asid61/MCL/MCL-102-2 IQ100 brushless/Sim/Draft1.asc

D1: schottky; 1N5818
M1: nmos; BSP89
R1: res; 330
R2: res; 2.2k
R3: res; 22k
R4: res; {X}
V1: voltage; PULSE(0 3.3 1m 10n 10n 1m 2m)
V2: voltage; 3.3
Named nets: 0, cs, brksw
.step param X list 1G 1
.tran 2m
