asid61/MCL/MCL-102-2 IQ100 brushless/Sim/Supplyvoltage.asc

C1: cap; 1360µ; V=25 Irms=4 Rser=20m
C2: cap; 12µ; x2
C3: cap; 10µ; Rser=1
C4: cap; 15µ; Rser=3m
D1: schottky; 1N5817
L1: ind; 3µ
L2: ind; 3µ
M1: nmos; Si7336ADP
R1: res; 40m
R2: res; 0.05
R3: res; 10
R4: res; 80
U1: ADP7118-3.3
V1: voltage; 12
V2: voltage; PULSE(0 12 0 10n 10n 25u 50u)
Named nets: 0
.tran 5m
