asid61/MCL/MCL-102-2 IQ100 brushless/MCL-102-2.kicad_pcb

## KiCad design MCL-102-2 IQ100 brushless/MCL-102-2.kicad_pcb (2025-07-22)

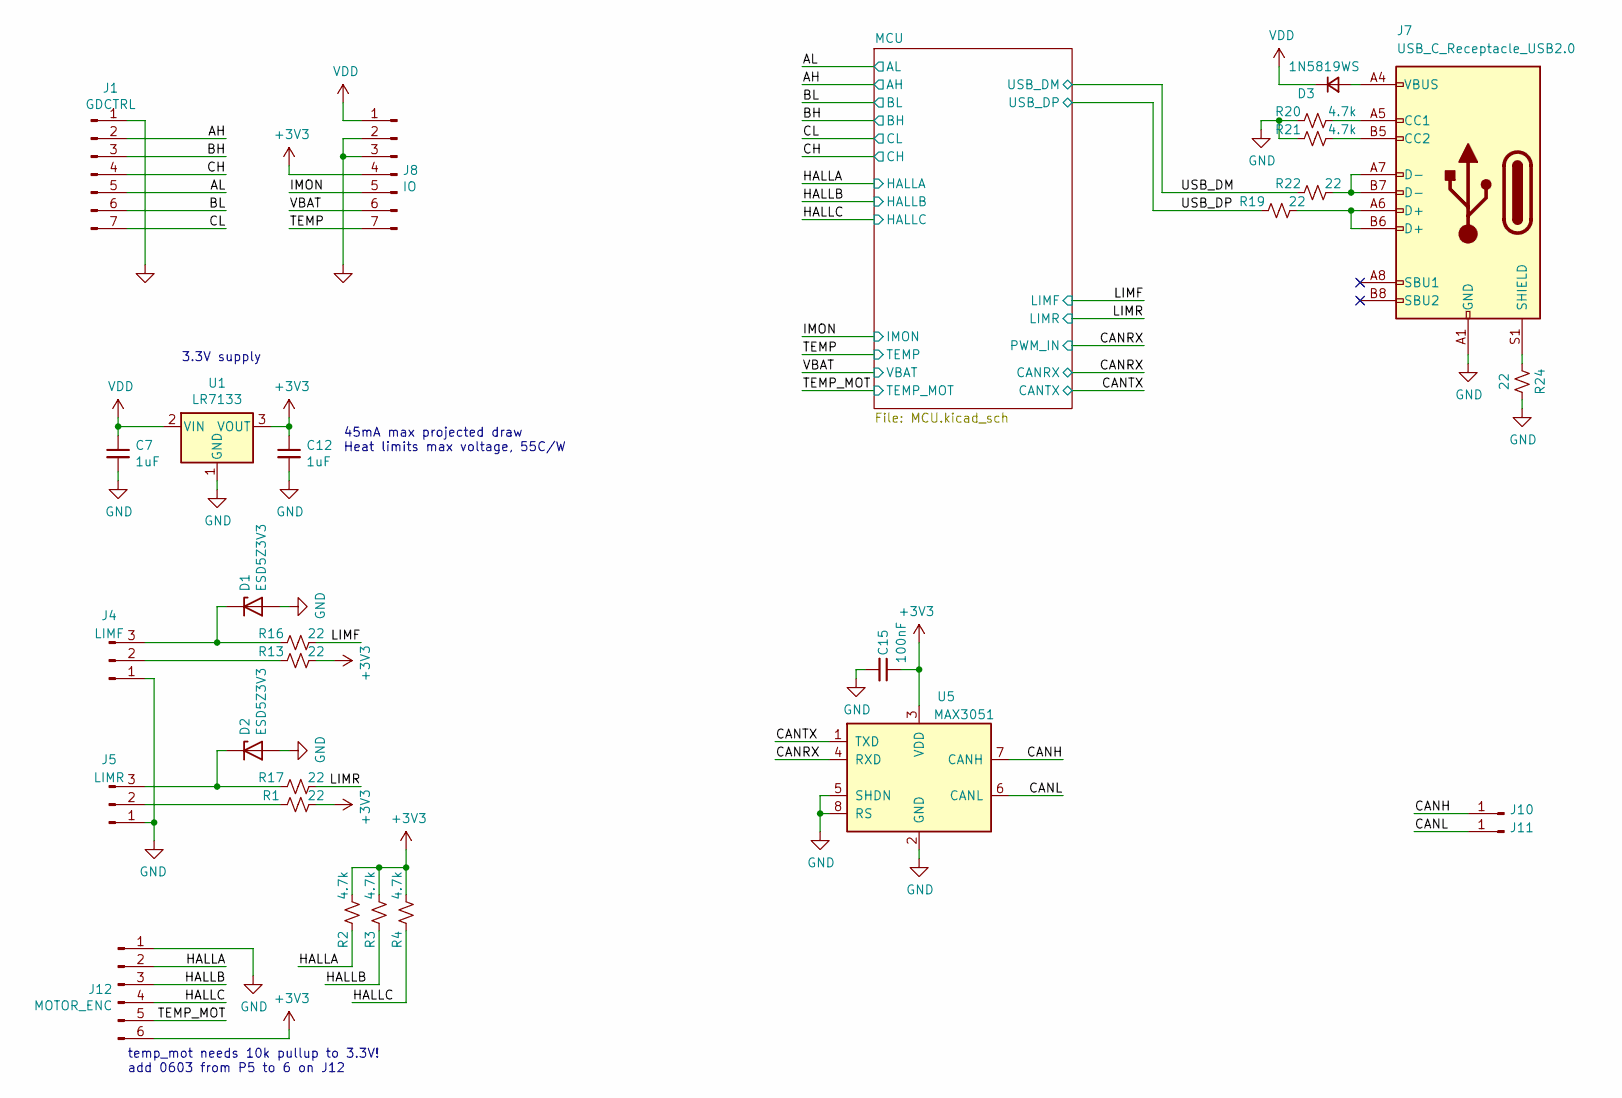
[picture p1: schematic MCL-102-2.kicad_sch]

Parts:
C7, C12: 1uF; C_0603_1608Metric; LCSC C15849
C15: 100nF; C_0402_1005Metric
D1, D2: ESD5Z3V3; D_SOD-523; LCSC C502545
D3: 1N5819WS; D_SOD-323; LCSC C191023
J1: GDCTRL; PinSocket_1x07_P2.54mm_Vertical; LCSC C492406
J4: LIMF; PinHeader_1x03_P2.54mm_Horizontal
J5: LIMR; PinHeader_1x03_P2.54mm_Horizontal
J7: USB_C_Receptacle_USB2.0; USB_C_Receptacle_HRO_TYPE-C-31-M-12; LCSC C165948
J8: IO; PinSocket_1x07_P2.54mm_Vertical; LCSC C492406
J10, J11: Conn_01x01_Male; SOLDERPAD_100x200
J12: MOTOR_ENC; JST_PH_S6B-PH-SM4-TB_1x06-1MP_P2.00mm_Horizontal; LCSC C146050
R1, R13, R16, R17, R19, R22, R24: 22; R_0402_1005Metric
R2, R3, R4, R20, R21: 4.7k; R_0402_1005Metric
U1: LR7133; SOT-89-3; LCSC C914127
U5: MAX3051; SOT-23-8; LCSC C112005

Connections:
+3V3: C12.1, C15.1, J8.4, J12.6, R1.2, R2.1, R3.1, R4.1, R13.2, U1.3 (VOUT), U5.3 (VDD); also elsewhere on the board
/AH: J1.2; also elsewhere on the board
/AL: J1.5; also elsewhere on the board
/BH: J1.3; also elsewhere on the board
/BL: J1.6; also elsewhere on the board
/CANH: J10.1, U5.7 (CANH)
/CANL: J11.1, U5.6 (CANL)
/CANRX: U5.4 (RXD); also elsewhere on the board
/CANTX: U5.1 (TXD); also elsewhere on the board
/CH: J1.4; also elsewhere on the board
/CL: J1.7; also elsewhere on the board
/HALLA: J12.2, R2.2; also elsewhere on the board
/HALLB: J12.3, R3.2; also elsewhere on the board
/HALLC: J12.4, R4.2; also elsewhere on the board
/IMON: J8.5; also elsewhere on the board
/LIMF: R16.2; also elsewhere on the board
/LIMR: R17.2; also elsewhere on the board
/TEMP: J8.7; also elsewhere on the board
/TEMP_MOT: J12.5; also elsewhere on the board
/USB_DM: R22.1; also elsewhere on the board
/USB_DP: R19.1; also elsewhere on the board
/VBAT: J8.6; also elsewhere on the board
GND: C7.2, C12.2, C15.2, D1.2 (A), D2.2 (A), J1.1, J4.1, J5.1, J7.A1 (GND), J7.A12 (GND), J7.B1 (GND), J7.B12 (GND), J8.2, J8.3, J12.1, R20.2, R21.2, R24.1, U1.1 (GND), U5.2 (GND), U5.5 (SHDN), U5.8 (RS); also elsewhere on the board
unnamed: D1.1 (K), J4.3, R16.1
unnamed: D2.1 (K), J5.3, R17.1
unnamed: D3.2 (A), J7.A4 (VBUS), J7.A9 (VBUS), J7.B4 (VBUS), J7.B9 (VBUS)
unnamed: J4.2, R13.1
unnamed: J5.2, R1.1
unnamed: J7.A5 (CC1), R20.1
unnamed: J7.A6 (D+), J7.B6 (D+), R19.2
unnamed: J7.A7 (D-), J7.B7 (D-), R22.2
unnamed: J7.B5 (CC2), R21.1
unnamed: J7.S1 (SHIELD), R24.2
VDD: C7.1, D3.1 (K), J8.1, U1.2 (VIN)

Notes on the sheet:
temp_mot needs 10k pullup to 3.3V! add 0603 from P5 to 6 on J12
3.3V supply
45mA max projected draw Heat limits max voltage, 55C/W

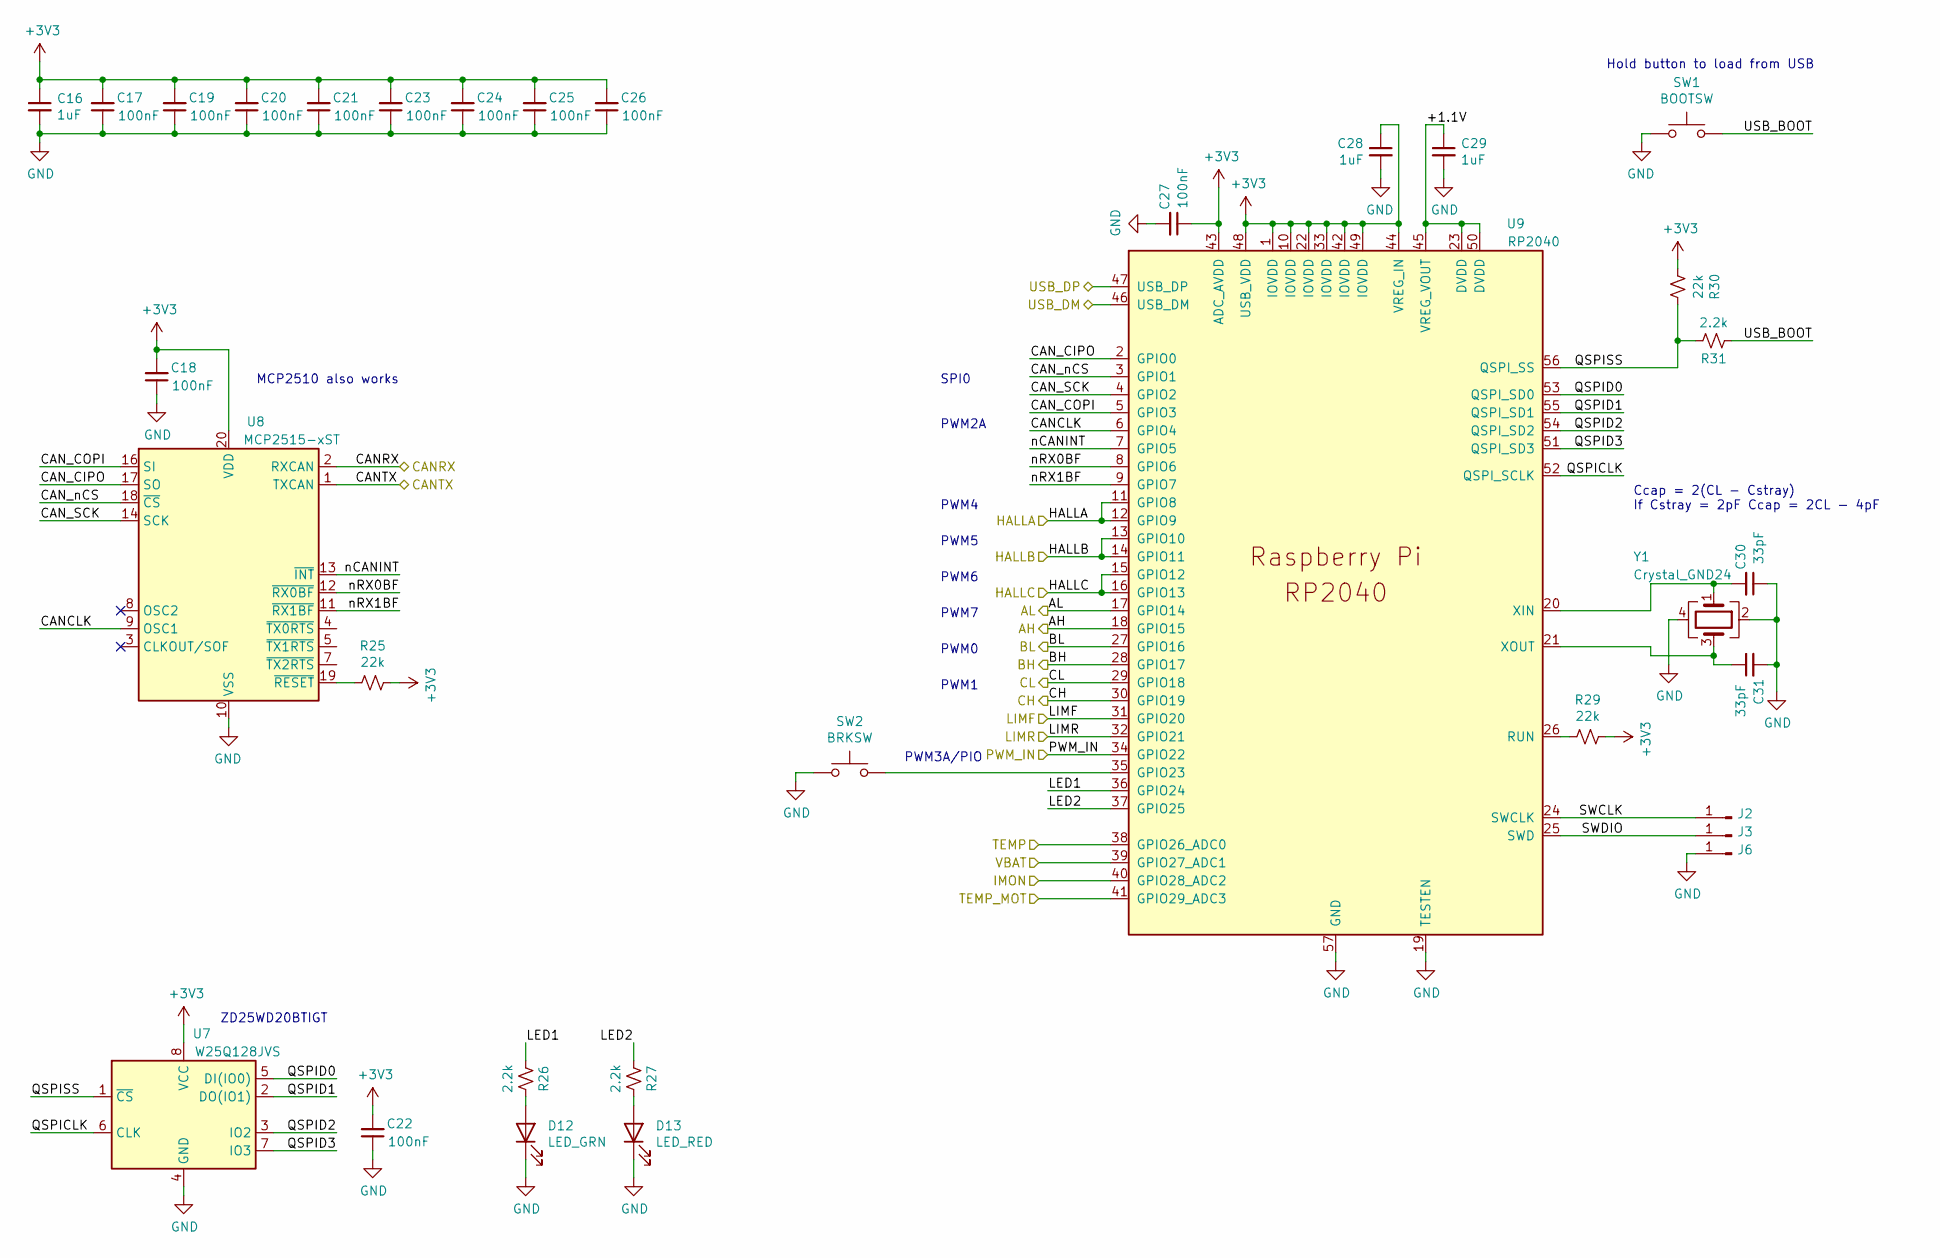
[picture p2: schematic MCU.kicad_sch]

Parts:
C16, C28, C29: 1uF; C_0603_1608Metric; LCSC C15849
C17, C18, C19, C20, C21, C22, C23, C24, C25, C26, C27: 100nF; C_0402_1005Metric
C30, C31: 33pF; C_0402_1005Metric
D12: LED_GRN; D_0603_1608Metric
D13: LED_RED; D_0603_1608Metric
J2, J3, J6: Conn_01x01_Male; SOLDERPAD_100x200
R25, R29, R30: 22k; R_0402_1005Metric
R26, R27, R31: 2.2k; R_0402_1005Metric
SW1: BOOTSW; SW_PUSH_6mm_H4.3mm; LCSC C2837531
SW2: BRKSW; SW_PUSH_6mm_H4.3mm; LCSC C2837531
U7: W25Q128JVS; SOIC-8_5.23x5.23mm_P1.27mm; LCSC C97521
U8: MCP2515-xST; TSSOP-20_4.4x6.5mm_P0.65mm; LCSC C185941
U9: RP2040; RP2040-QFN-56; LCSC C2040
Y1: Crystal_GND24; Crystal_SMD_3225-4Pin_3.2x2.5mm; LCSC C9002

Connections:
+3V3: C16.1, C17.2, C18.2, C19.2, C20.2, C21.2, C22.2, C23.2, C24.2, C25.2, C26.2, C27.1, C28.1, R25.2, R29.2, R30.1, U7.8 (VCC), U8.20 (VDD), U9.1 (IOVDD), U9.10 (IOVDD), U9.22 (IOVDD), U9.33 (IOVDD), U9.42 (IOVDD), U9.43 (ADC_AVDD), U9.44 (VREG_IN), U9.48 (USB_VDD), U9.49 (IOVDD); also elsewhere on the board
/AH: U9.18 (GPIO15); also elsewhere on the board
/AL: U9.17 (GPIO14); also elsewhere on the board
/BH: U9.28 (GPIO17); also elsewhere on the board
/BL: U9.27 (GPIO16); also elsewhere on the board
/CANRX: U8.2 (RXCAN), U9.34 (GPIO22); also elsewhere on the board
/CANTX: U8.1 (TXCAN); also elsewhere on the board
/CH: U9.30 (GPIO19); also elsewhere on the board
/CL: U9.29 (GPIO18); also elsewhere on the board
/HALLA: U9.11 (GPIO8), U9.12 (GPIO9); also elsewhere on the board
/HALLB: U9.13 (GPIO10), U9.14 (GPIO11); also elsewhere on the board
/HALLC: U9.15 (GPIO12), U9.16 (GPIO13); also elsewhere on the board
/IMON: U9.40 (GPIO28_ADC2); also elsewhere on the board
/LIMF: U9.31 (GPIO20); also elsewhere on the board
/LIMR: U9.32 (GPIO21); also elsewhere on the board
/MCU/+1.1V: C29.1, U9.23 (DVDD), U9.45 (VREG_VOUT), U9.50 (DVDD)
/MCU/CANCLK: U8.9 (OSC1), U9.6 (GPIO4)
/MCU/CAN_CIPO: U8.17 (SO), U9.2 (GPIO0)
/MCU/CAN_COPI: U8.16 (SI), U9.5 (GPIO3)
/MCU/CAN_SCK: U8.14 (SCK), U9.4 (GPIO2)
/MCU/CAN_nCS: U8.18 (~CS), U9.3 (GPIO1)
/MCU/LED1: R26.2, U9.36 (GPIO24)
/MCU/LED2: R27.2, U9.37 (GPIO25)
/MCU/QSPICLK: U7.6 (CLK), U9.52 (QSPI_SCLK)
/MCU/QSPID0: U7.5 (DI(IO0)), U9.53 (QSPI_SD0)
/MCU/QSPID1: U7.2 (DO(IO1)), U9.55 (QSPI_SD1)
/MCU/QSPID2: U7.3 (IO2), U9.54 (QSPI_SD2)
/MCU/QSPID3: U7.7 (IO3), U9.51 (QSPI_SD3)
/MCU/QSPISS: R30.2, R31.1, U7.1 (~CS), U9.56 (QSPI_SS)
/MCU/SWCLK: J2.1, U9.24 (SWCLK)
/MCU/SWDIO: J3.1, U9.25 (SWD)
/MCU/USB_BOOT: R31.2, SW1.2
/MCU/nCANINT: U8.13 (~INT), U9.7 (GPIO5)
/MCU/nRX0BF: U8.12 (~RX0BF), U9.8 (GPIO6)
/MCU/nRX1BF: U8.11 (~RX1BF), U9.9 (GPIO7)
/TEMP: U9.38 (GPIO26_ADC0); also elsewhere on the board
/TEMP_MOT: U9.41 (GPIO29_ADC3); also elsewhere on the board
/USB_DM: U9.46 (USB_DM); also elsewhere on the board
/USB_DP: U9.47 (USB_DP); also elsewhere on the board
/VBAT: U9.39 (GPIO27_ADC1); also elsewhere on the board
GND: C16.2, C17.1, C18.1, C19.1, C20.1, C21.1, C22.1, C23.1, C24.1, C25.1, C26.1, C27.2, C28.2, C29.2, C30.1, C31.2, D12.1 (K), D13.1 (K), J6.1, SW1.1, SW2.1, U7.4 (GND), U8.10 (VSS), U9.19 (TESTEN), U9.57 (GND), Y1.2, Y1.4; also elsewhere on the board
unnamed: C30.2, U9.20 (XIN), Y1.1
unnamed: C31.1, U9.21 (XOUT), Y1.3
unnamed: D12.2 (A), R26.1
unnamed: D13.2 (A), R27.1
unnamed: R25.1, U8.19 (~RESET)
unnamed: R29.1, U9.26 (RUN)
unnamed: SW2.2, U9.35 (GPIO23)

Notes on the sheet:
Hold button to load from USB
PWM5
PWM7
PWM1
PWM3A/PIO
MCP2510 also works
PWM2A
Ccap = 2(CL - Cstray) If Cstray = 2pF Ccap = 2CL - 4pF
PWM6
ZD25WD20BTIGT
SPI0
PWM0
PWM4

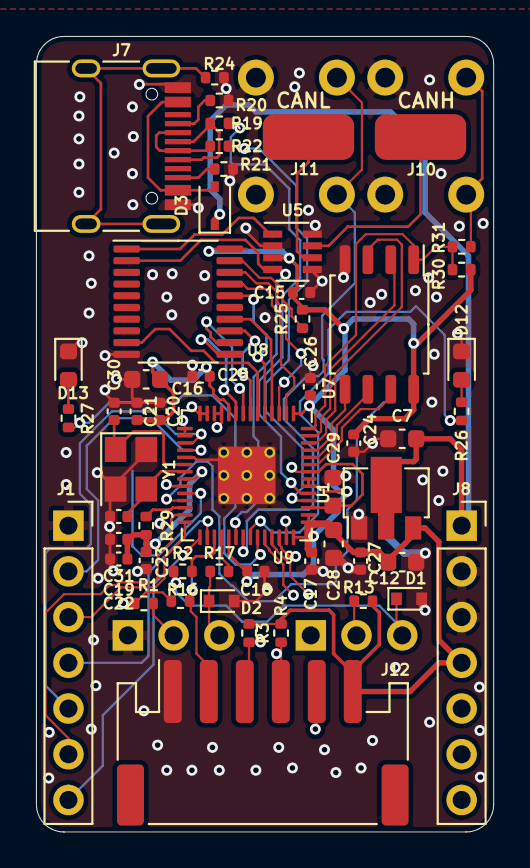
[picture p3: board MCL-102-2.kicad_pcb from above]

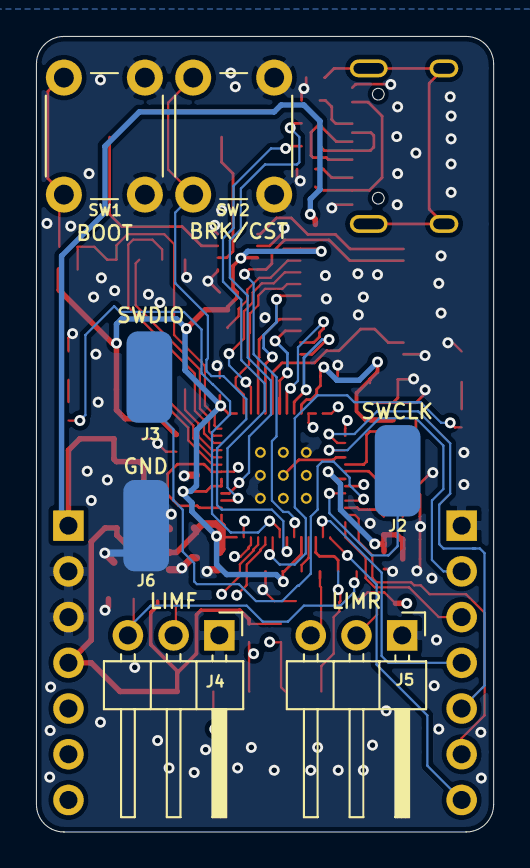
[picture p4: board MCL-102-2.kicad_pcb from below]

Board: 4 copper layers, 25.4 x 44.2 mm, 61 parts (7 on the bottom side), 61 nets.
