asid61/MCL/MCL-102-2 IQ100 brushless/MCL-102 Bridge/MCL-102 Bridge.kicad_pcb

## KiCad design MCL-102-2 IQ100 brushless/MCL-102 Bridge/MCL-102 Bridge.kicad_pcb (2025-07-22)

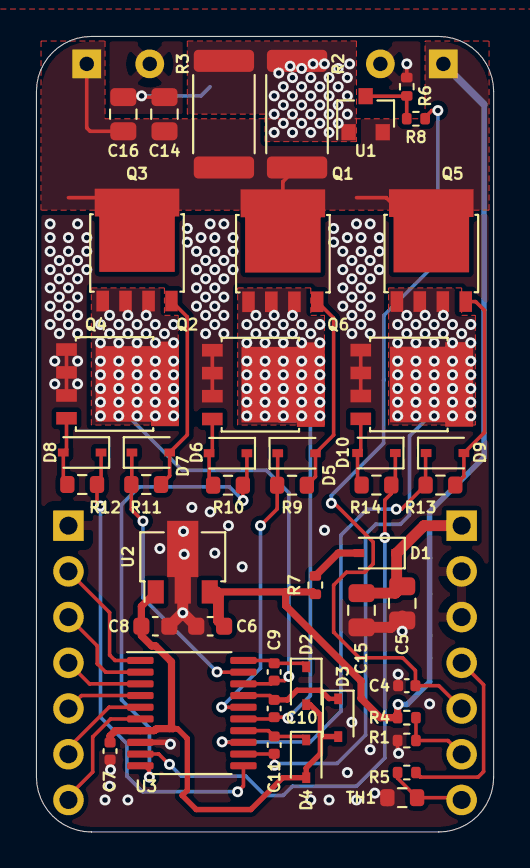
[picture p5: board MCL-102 Bridge.kicad_pcb from above]

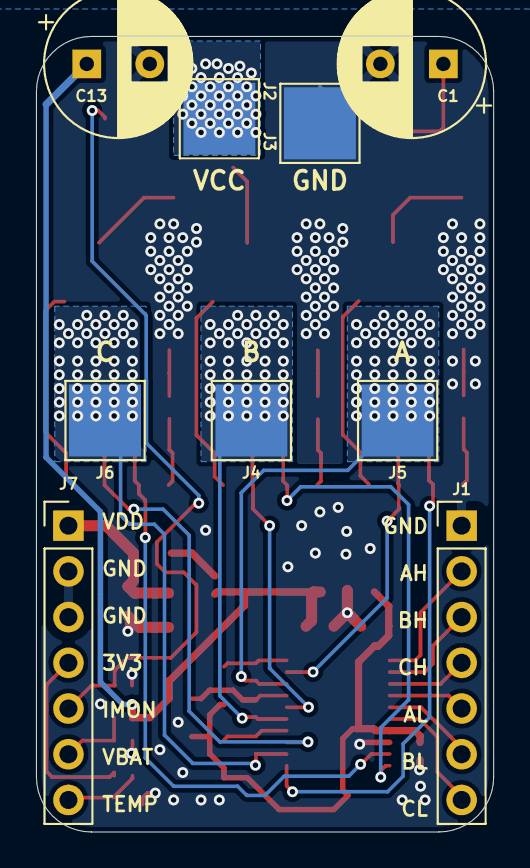
[picture p6: board MCL-102 Bridge.kicad_pcb from below]

Board: 4 copper layers, 25.4 x 44.2 mm, 54 parts (9 on the bottom side), 35 nets.

Parts:
C1, C13: 680uF; CP_Radial_D8.0mm_P3.50mm
C4, C7, C9, C10, C11: 100nF; C_0402_1005Metric
C5, C14, C15, C16: 22uF; C_0805_2012Metric
C6, C8: 1uF; C_0603_1608Metric
D1, D2, D3, D4, D5, D6, D7, D8, D9, D10: 1N4148WS; D_SOD-323
J1: GDCTRL; PinHeader_1x07_P2.54mm_Vertical
J2, J3, J4, J5, J6: Conn_01x01_Male; TestPoint_Pad_4.0x4.0mm
J7: IO; PinHeader_1x07_P2.54mm_Vertical
Q1, Q2, Q3, Q4, Q5, Q6: HYG013N03LS1C2; LFPAK56
R1: 4.7k; R_0402_1005Metric
R2, R3: 0.001; R_2512_6332Metric
R4: 22k; R_0402_1005Metric
R5, R6, R8: 2.2k; R_0402_1005Metric
R7: 22; R_0402_1005Metric
R9, R10, R11, R12, R13, R14: 1; R_0603_1608Metric
TH1: 10k; R_0603_1608Metric
U1: ZXCT1009F; SOT-23
U2: L78L12_SOT89; SOT-89-3
U3: EG2133; TSSOP-20_4.4x6.5mm_P0.65mm

Connections:
+3V3: J7.4, R1.2
+12V: C7.2, C8.1, D2.2 (A), D3.2 (A), D4.2 (A), U2.1 (OUT), U3.7 (VCC)
/AH: J1.2, U3.1 (HIN1)
/AHO: D7.1 (K), R11.1, U3.19 (HO1)
/AL: J1.5, U3.4 (~LIN1)
/ALO: D8.1 (K), R12.1, U3.11 (LO1)
/BH: J1.3, U3.2 (HIN2)
/BHO: D5.1 (K), R9.1, U3.16 (HO2)
/BL: J1.6, U3.5 (~LIN2)
/BLO: D6.1 (K), R10.1, U3.10 (LO2)
/CH: J1.4, U3.3 (HIN3)
/CHO: D9.1 (K), R13.1, U3.13 (HO3)
/CL: J1.7, U3.6 (~LIN3)
/CLO: D10.1 (K), R14.1, U3.9 (LO3)
/IMON: C4.2, J7.5, R8.2
/MA: C9.1, J5.1, Q3.1 (S), Q3.2 (S), Q3.3 (S), Q4.5 (D), U3.18 (VS1)
/MB: C10.1, J4.1, Q1.1 (S), Q1.2 (S), Q1.3 (S), Q2.5 (D), U3.15 (VS2)
/MC: C11.1, J6.1, Q5.1 (S), Q5.2 (S), Q5.3 (S), Q6.5 (D), U3.12 (VS3)
/PHASEA/HD: D5.2 (A), Q1.4 (G), R9.2
/PHASEA/LD: D6.2 (A), Q2.4 (G), R10.2
/PHASEB/HD: D7.2 (A), Q3.4 (G), R11.2
/PHASEB/LD: D8.2 (A), Q4.4 (G), R12.2
/Temp: J7.7, R1.1, TH1.1
/VBAT: J7.6, R4.2, R5.1
/sheet6191AFC6/HD: D9.2 (A), Q5.4 (G), R13.2
/sheet6191AFC6/LD: D10.2 (A), Q6.4 (G), R14.2
GND: C1.2, C4.1, C5.2, C6.2, C7.1, C8.2, C13.2, C14.2, C15.2, C16.2, J1.1, J3.1, J7.2, J7.3, Q2.1 (S), Q2.2 (S), Q2.3 (S), Q4.1 (S), Q4.2 (S), Q4.3 (S), Q6.1 (S), Q6.2 (S), Q6.3 (S), R5.2, R6.2, TH1.2, U2.2 (GND), U3.8 (GND)
unnamed: C9.2, D2.1 (K), U3.20 (VB1)
unnamed: C10.2, D3.1 (K), U3.17 (VB2)
unnamed: C11.2, D4.1 (K), U3.14 (VB3)
unnamed: D1.2 (A), R7.2
unnamed: J2.1, R2.1, R3.1, U1.1 (Vs-)
unnamed: R6.1, R8.1, U1.3 (Iout)
VCC: C1.1, C6.1, C13.1, C14.1, C16.1, Q1.5 (D), Q3.5 (D), Q5.5 (D), R2.2, R3.2, R4.1, R7.1, U1.2 (Vs+), U2.3 (IN)
VDD: C5.1, C15.1, D1.1 (K), J7.1
